unreproducible/battlebunnies/battle bunnies silk.bmp

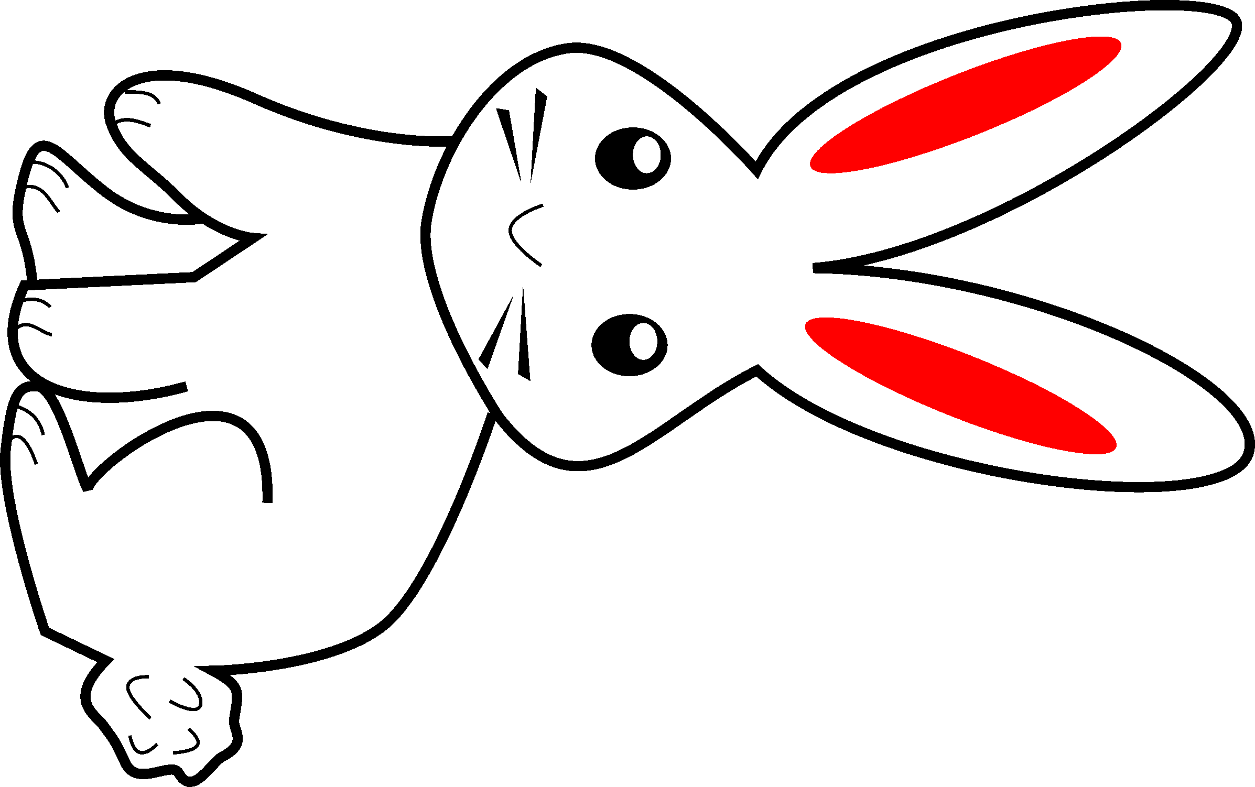
battle bunnies silk.bmp
