unreproducible/battlebunnies/battlebunnies outline r9.dxf

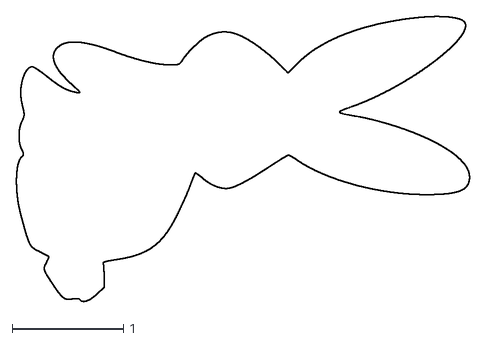
[picture p2: CAD file, 2017-01-02]
battlebunnies outline r9.dxf
4.07 x 2.56
