unreproducible/battlebunnies/battlebunnies outline r12.dxf

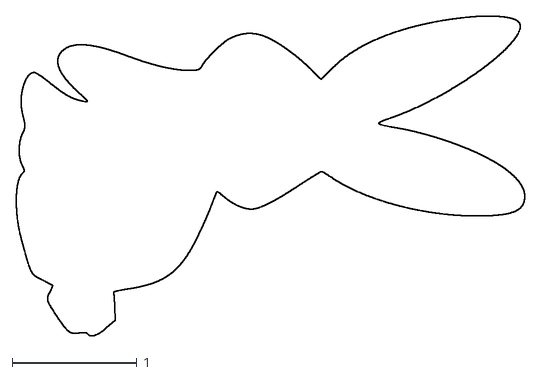
[picture p3: CAD file, 2017-01-02]
battlebunnies outline r12.dxf
4.07 x 2.56
