unreproducible/battlebunnies/battlebunnies outline.dxf

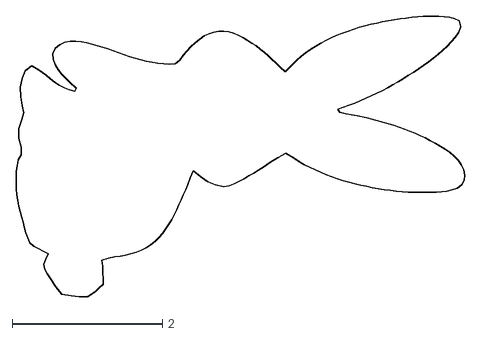
[picture p4: CAD file, 2017-01-02]
battlebunnies outline.dxf
5.97 x 3.74
