unreproducible/battlebunnies/battlebunnies outline r12 v2.dxf

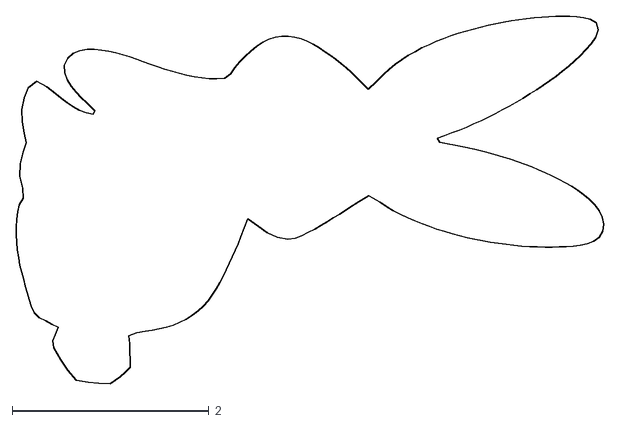
[picture p5: CAD file, 2017-01-02]
battlebunnies outline r12 v2.dxf
5.97 x 3.74
