unreproducible/battlebunnies/battle bunnies.brd

## EAGLE design battle bunnies.brd (2018-04-06)

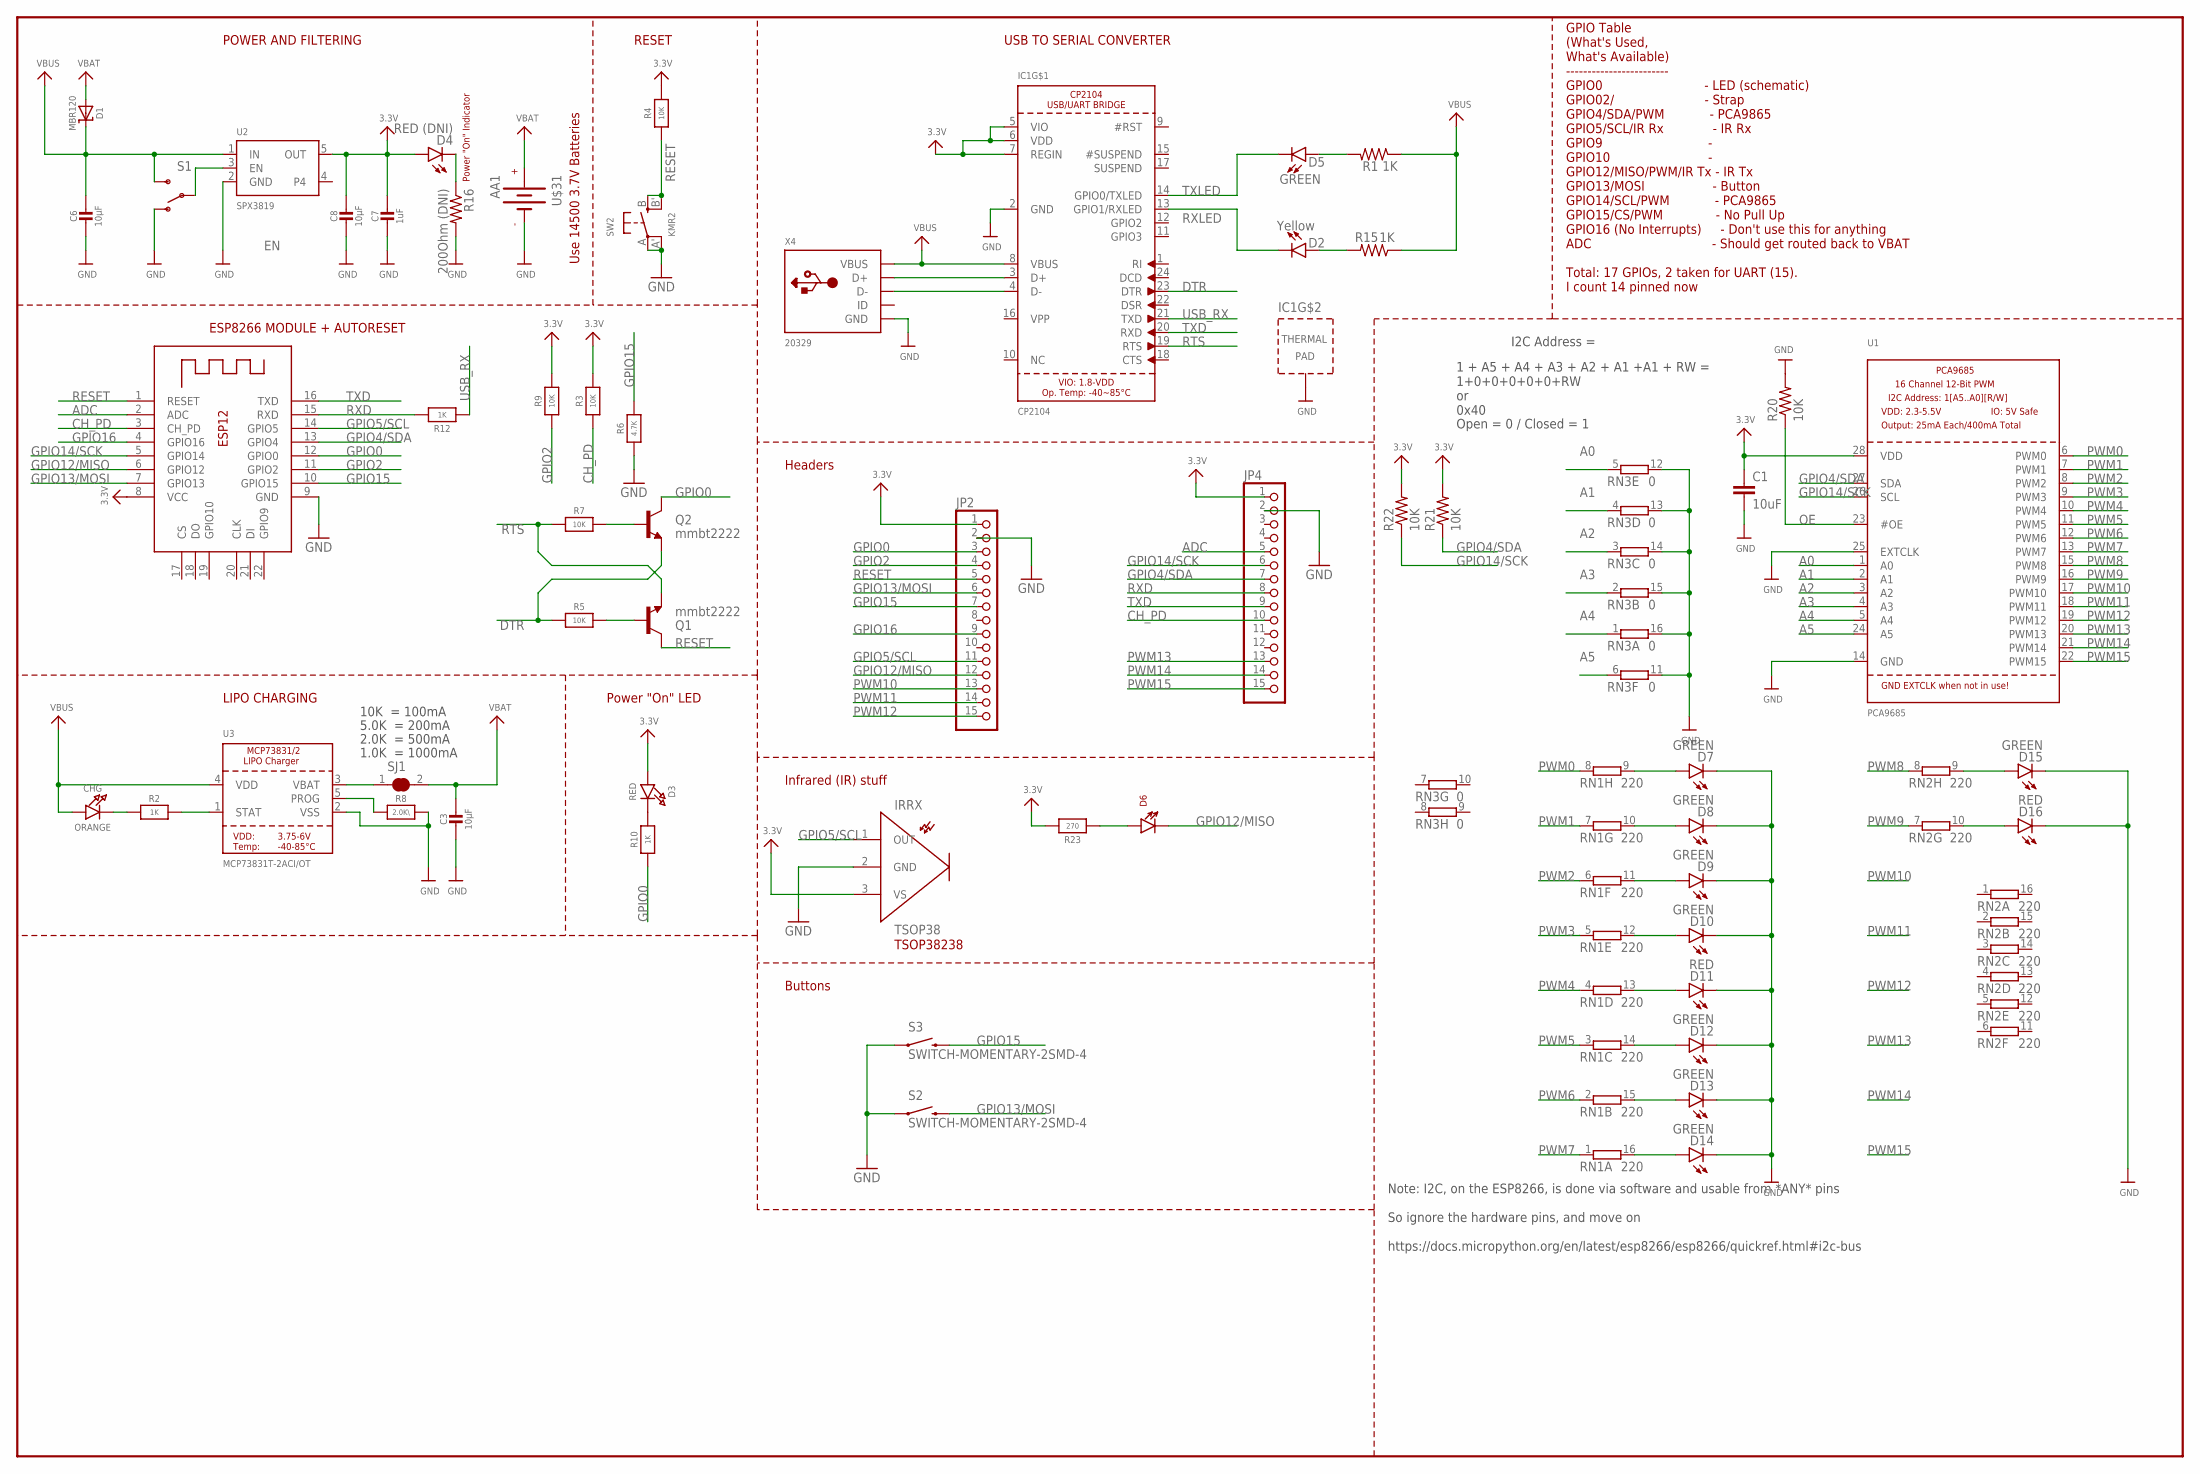
[picture p6: schematic battle bunnies.sch]

Parts:
C1: 10uF; 0805-CAP
C3, C6, C8: 10µF; 0805-NO
C7: 1uF; 0603-NO
CHG: ORANGE; CHIPLED_0805_NOOUTLINE
D1: MBR120; SOD-123
D2: Yellow; LED-0603
D3: RED; CHIPLED_0805_NOOUTLINE
D4: RED (DNI); LED-0603
D5, D7, D8, D9, D10, D12, D13, D14, D15: GREEN; LED-0603
D6: LTE-302
D11, D16: RED; LED-0603
IC1: CP2104; QFN24_4MM_SMSC
IRRX: TSOP38
JP2, JP4: PINHD-1X15; 1X15
Q1, Q2: mmbt2222; SOT23-3
R1, R15: 1K; 0603-RES
R2, R10: 1K; 0603-NO
R3, R4, R5, R9: 10K; 0603-NO
R6: 4.7K; 0603-NO
R7: 10K; _0603MP
R8: 2.0K\; 0603-NO
R12: 1K; _0603MP
R16: 200Ohm (DNI); 0603-RES
R20, R21, R22: 10K; 0805
R23: 270; 0603-NO
RN1, RN2: 220; EXB2HV
RN3: 0; EXB2HV
S1: SWITCH-SPDT-SMD-A; SWITCH-SPST-SMD-A
S2, S3: SWITCH-MOMENTARY-2SMD-4; TACTILE_SWITCH_TALL
SJ1: SOLDERJUMPER_CLOSED; SOLDERJUMPER_CLOSEDWIRE@1
SW2: KMR2; BTN_KMR2_4.6X2.8
U1: PCA9685; TSSOP28
U2: SPX3819; SOT23-5
U3: MCP73831T-2ACI/OT; SOT23-5
U$31: AA1
X2: ESP-12; ESP-12E
X4: 20329; MICRO-USB5+6P-SMD-0.65-B

Connections:
3.3V: C1.1, C7.1, C8.1, D3.A, D4.A, IC1.5 (VIO), IC1.6 (VDD), IC1.7 (REGIN), IRRX.3 (VS), JP2.1, JP4.1, R1.1, R3.2, R4.2, R9.2, R15.1, R21.2, R22.2, R23.2, U1.28 (VDD), U2.5 (OUT), X2.8 (VCC)
A0: RN3.5 (1), U1.1 (A0)
A1: RN3.4 (1), U1.2 (A1)
A2: RN3.3 (1), U1.3 (A2)
A3: RN3.2 (1), U1.4 (A3)
A4: RN3.1, U1.5 (A4)
A5: RN3.6 (1), U1.24 (A5)
ADC: JP4.5, X2.2 (ADC)
CH_PD: JP4.10, R3.1, X2.3 (CH_PD)
DTR: IC1.23 (DTR), Q2.2 (E), R5.1
EN: S1.2, U2.3 (EN)
GND: C1.2, C3.2, C6.2, C7.2, C8.2, D7.C, D8.C, D9.C, D10.C, D11.C, D12.C, D13.C, D14.C, D15.C, D16.C, IC1.2 (GND), IC1.THERM (TP), IRRX.2 (GND), JP2.2, JP4.2, R6.1, R8.2, R16.2, R20.2, RN3.11 (2), RN3.12 (2), RN3.13 (2), RN3.14 (2), RN3.15 (2), RN3.16 (2), S1.1 (O), S2.A2 (1), S3.A2 (1), SW2.A, SW2.A' (P1), U1.14 (GND), U1.25 (EXTCLK), U2.2 (GND), U3.2 (VSS), U$31.NEG (-), X2.9 (GND), X4.5 (GND), X4.S1 (GND), X4.S2 (GND), X4.S3 (GND), X4.S4 (GND), X4.S5 (GND), X4.S6 (GND)
GPIO0: JP2.3, Q2.3 (C), R10.1, X2.12 (GPIO0)
GPIO2: JP2.4, R9.1, X2.11 (GPIO2)
GPIO4/SDA: JP4.7, R21.1, U1.27 (SDA), X2.13 (GPIO4)
GPIO5/SCL: IRRX.1 (OUT), JP2.11, X2.14 (GPIO5)
GPIO12/MISO: D6.C, JP2.12, X2.6 (GPIO12)
GPIO13/MOSI: JP2.6, S2.B2 (2), X2.7 (GPIO13)
GPIO14/SCK: JP4.6, R22.1, U1.26 (SCL), X2.5 (GPIO14)
GPIO15: JP2.7, R6.2, S3.B2 (2), X2.10 (GPIO15)
GPIO16: JP2.9, X2.4 (GPIO16)
unnamed: CHG.C, R2.1
unnamed: R8.1, U3.5 (PROG)
unnamed: R2.2, U3.1 (STAT)
unnamed: D4.C, R16.1
unnamed: D3.C, R10.2
unnamed: D5.A, R1.2
unnamed: SJ1.1, U3.3 (VBAT)
unnamed: D2.A, R15.2
unnamed: Q1.1 (B), R5.2
unnamed: Q2.1 (B), R7.2
unnamed: D6.A, R23.1
unnamed: D13.A, RN1.15 (2)
unnamed: D14.A, RN1.16 (2)
unnamed: D12.A, RN1.14 (2)
unnamed: D11.A, RN1.13 (2)
unnamed: D10.A, RN1.12 (2)
unnamed: D9.A, RN1.11 (2)
unnamed: D8.A, RN1.10 (2)
unnamed: D7.A, RN1.9 (2)
unnamed: D15.A, RN2.9 (2)
unnamed: D16.A, RN2.10 (2)
OE: R20.1, U1.23 (#OE)
PWM0: RN1.8 (1), U1.6 (PWM0)
PWM1: RN1.7 (1), U1.7 (PWM1)
PWM2: RN1.6 (1), U1.8 (PWM2)
PWM3: RN1.5 (1), U1.9 (PWM3)
PWM4: RN1.4 (1), U1.10 (PWM4)
PWM5: RN1.3 (1), U1.11 (PWM5)
PWM6: RN1.2 (1), U1.12 (PWM6)
PWM7: RN1.1, U1.13 (PWM7)
PWM8: RN2.8 (1), U1.15 (PWM8)
PWM9: RN2.7 (1), U1.16 (PWM9)
PWM10: JP2.13, U1.17 (PWM10)
PWM11: JP2.14, U1.18 (PWM11)
PWM12: JP2.15, U1.19 (PWM12)
PWM13: JP4.13, U1.20 (PWM13)
PWM14: JP4.14, U1.21 (PWM14)
PWM15: JP4.15, U1.22 (PWM15)
RESET: JP2.5, Q1.3 (C), R4.1, SW2.B (S), SW2.B' (S1), X2.1 (RESET)
RTS: IC1.19 (RTS), Q1.2 (E), R7.1
RXD: JP4.8, R12.2, X2.15 (RXD)
RXLED: D2.C, IC1.13 (GPIO1/RXLED)
TXD: IC1.20 (RXD), JP4.9, X2.16 (TXD)
TXLED: D5.C, IC1.14 (GPIO0/TXLED)
USBD_N: IC1.4 (D-), X4.2 (D-)
USBD_P: IC1.3 (D+), X4.3 (D+)
USB_RX: IC1.21 (TXD), R12.1
VBAT: C3.1, D1.A, SJ1.2, U$31.POS (+)
VBUS: C6.1, CHG.A, D1.C, IC1.8 (VBUS), S1.3 (S), U2.1 (IN), U3.4 (VDD), X4.1 (VBUS)

Notes on the sheet:
POWER AND FILTERING
RESET
10K = 100mA
5.0K = 200mA
2.0K = 500mA
1.0K = 1000mA
USB TO SERIAL CONVERTER
LIPO CHARGING
Power "On" LED
ESP8266 MODULE + AUTORESET
Power "On" Indicator
GPIO Table (What's Used, What's Available) ------------------------ GPIO0 - LED (schematic) GPIO02/ - Strap GPIO4/SDA/PWM - PCA9865 GPIO5/SCL/IR Rx - IR Rx GPIO9 - GPIO10 - GPIO12/MISO/PWM/IR Tx - IR Tx GPIO13/MOSI - Button GPIO14/SCL/PWM - PCA9865 GPIO15/CS/PWM - No Pull Up GPIO16 (No Interrupts) 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
1 + A5 + A4 + A3 + A2 + A1 +A1 + RW = 1+0+0+0+0+0+RW or 0x40
I2C Address =
Open = 0 / Closed = 1
Note: I2C, on the ESP8266, is done via software and usable from *ANY* pins So ignore the hardware pins, and move on https://docs.micropython.org/en/latest/esp8266/esp8266/quickref.html#i2c-bus
Headers
Infrared (IR) stuff
TSOP38238
Buttons
Use 14500 3.7V Batteries

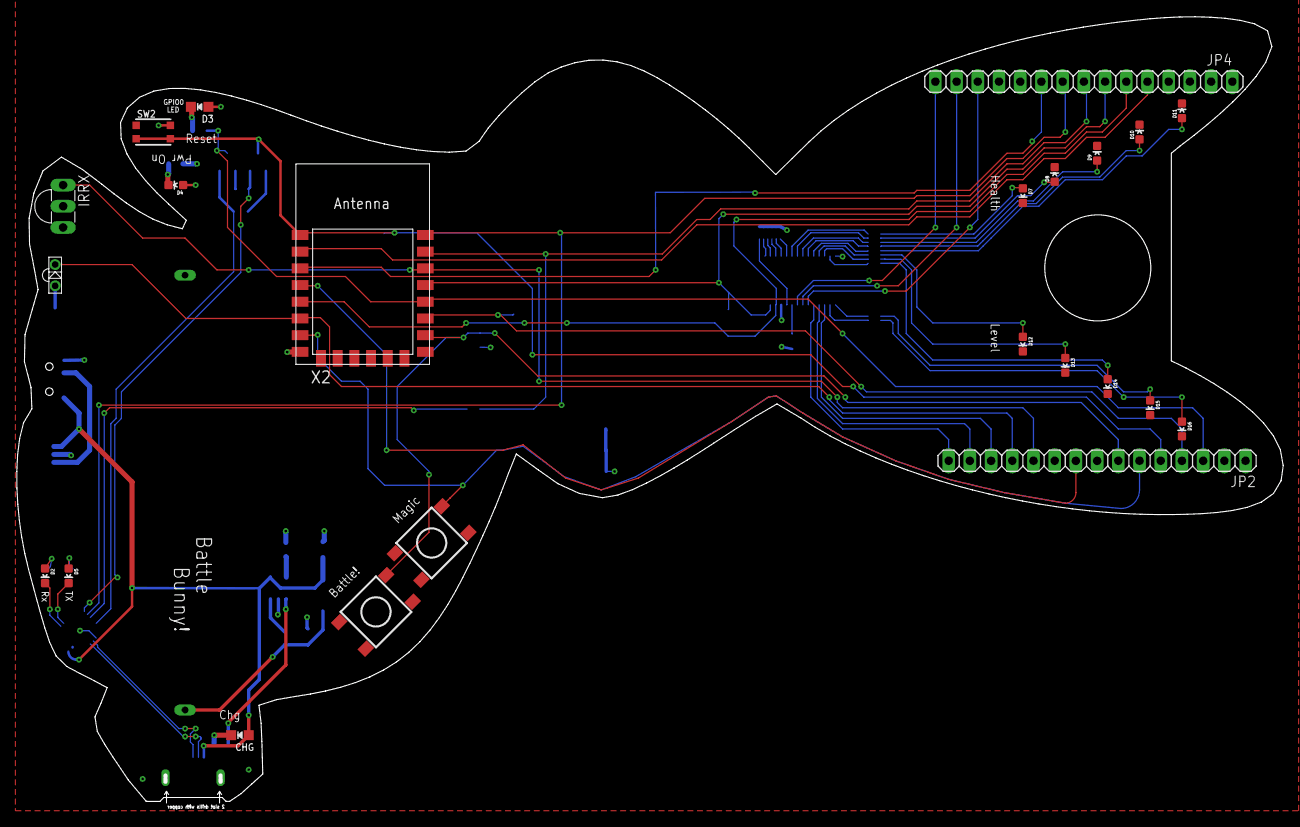
[picture p7: board battle bunnies.brd from above]

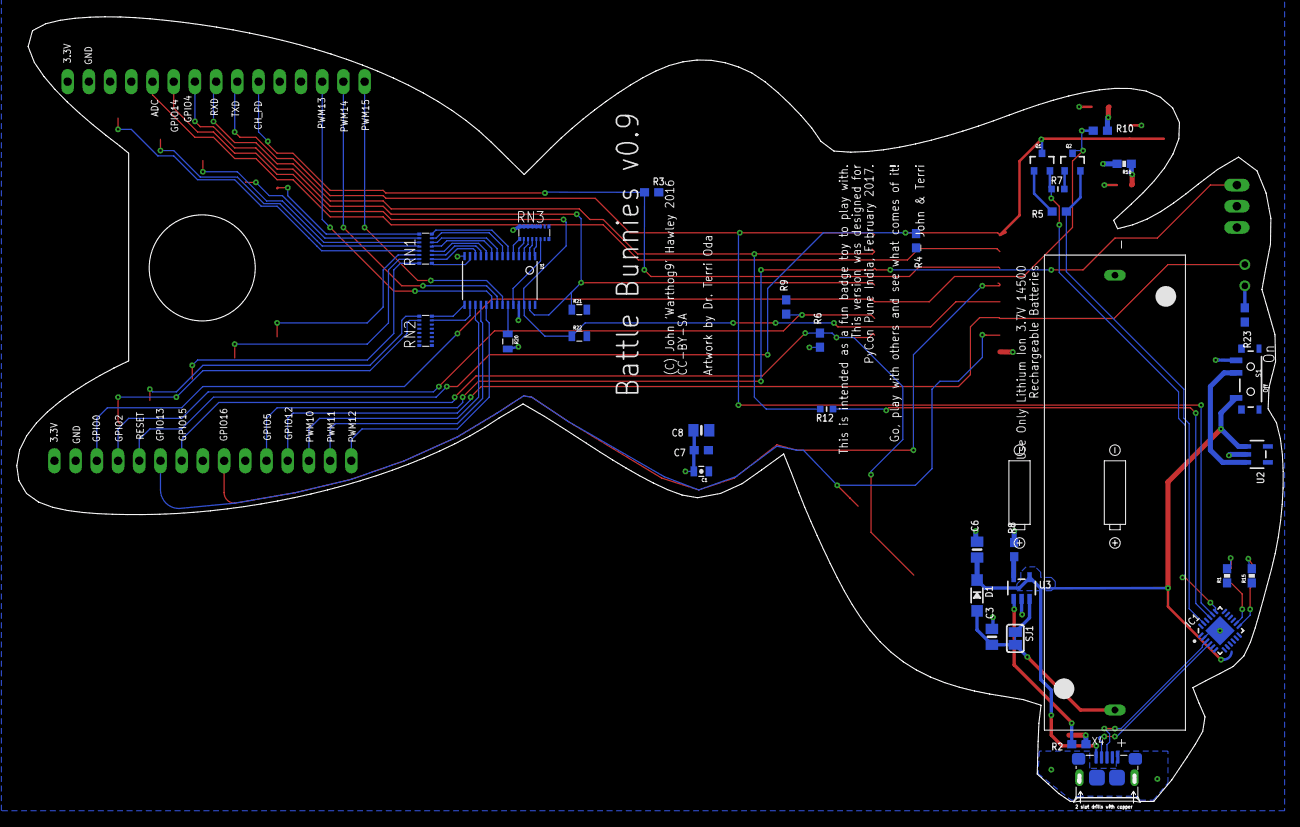
[picture p8: board battle bunnies.brd from below]

Board: 2 copper layers, 151.7 x 94.0 mm, 59 parts (36 on the bottom side), 70 nets.
