unreproducible/battlebunnies/(commit log)

2017-01-02 Adding Board Schematic, Layout, & additional files for design
    [battle bunnies.brd, battle bunnies.sch, battlebunnies outline r12 v2.dxf, battlebunnies outline r12.dxf, battlebunnies outline r9.dxf, battlebunnies outline.dxf]
2017-01-02 Re-working for amica module
    [battle bunnies.brd, battle bunnies.sch]
2018-04-06 USB: Swapping the USB part out - twas unobtanium
    The 4UCONN connector that Adafruit used is basically made of unobtanium
    and more or less doesn't exist. The part that was trying to be used
    the rear prongs did not match up by any stretch of the imagination.
    A mess of e-mails an annoyance ensued.
    I'm swapping out the part on everything I can now, this seems to be
    more common, and there's parts that are similar enough to it that
    replacing it won't be a big deal. New part is the
    Amphenol FCI 10118193-0001LF
    [battle bunnies.brd, battle bunnies.sch]
